kkrizka/pbv2_mass_test_adapter/(commit log)

2017-06-23 Initial import.
    [pbv2_7_test_adapters.sch, pbv2_mass_test_adapter.kicad_pcb, pbv2_mass_test_adapter.sch, pbv2_test_adapter.sch]
2017-06-23 Unique sheet names.
    [pbv2_7_test_adapters.sch, pbv2_mass_test_adapter.sch, pbv2_test_adapter.sch]
2017-06-23 Started adding HV connectors.
    [pbv2_7_test_adapters.sch, pbv2_mass_test_adapter.kicad_pcb, pbv2_mass_test_adapter.sch, pbv2_test_adapter.sch]
2017-06-23 Schematic complete.
    [pbv2_7_test_adapters.sch, pbv2_mass_test_adapter.sch, pbv2_test_adapter.sch]
2017-06-23 aesthetic changes
    [pbv2_mass_test_adapter.sch]
2017-08-11 pads for one PB layed-out
    [pbv2_7_test_adapters.sch, pbv2_mass_test_adapter.kicad_pcb, pbv2_test_adapter.sch]
2017-08-14 Start of routing.
    [pbv2_mass_test_adapter.kicad_pcb, pbv2_mass_test_adapter.sch]
2017-08-14 Relayout one PB station.
    [pbv2_mass_test_adapter.kicad_pcb, pbv2_mass_test_adapter.sch, pbv2_test_adapter.sch]
2017-08-15 Array all of the components.
    [pbv2_mass_test_adapter.kicad_pcb, pbv2_mass_test_adapter.sch]
2017-08-15 Relayed out master PB station with the output right above it.
    [pbv2_mass_test_adapter.kicad_pcb, pbv2_mass_test_adapter.sch]
2017-08-15 Started adding output ports for other mass sheets.
    [pbv2_7_test_adapters.sch, pbv2_mass_test_adapter.kicad_pcb, pbv2_mass_test_adapter.sch, pbv2_test_adapter.sch]
2017-08-15 start work on other sheets
    [pbv2_7_test_adapters.sch, pbv2_mass_test_adapter.sch, pbv2_test_adapter.sch]
2017-08-15 Moved the output ports for all sheets.
    [pbv2_mass_test_adapter.kicad_pcb, pbv2_test_adapter.sch]
2017-08-15 Turned individual test stations into a 2D grid.
    [pbv2_mass_test_adapter.kicad_pcb]
2017-08-15 Initial layout ccompleted.
    [pbv2_mass_test_adapter.kicad_pcb]
2017-08-16 Fixed a bunch of PCB errors.
    [pbv2_7_test_adapters.sch, pbv2_mass_test_adapter.kicad_pcb, pbv2_mass_test_adapter.sch, pbv2_test_adapter.sch]
2017-08-17 Remove stopmass from PB cooling pads.
    [pbv2_mass_test_adapter.kicad_pcb]
2017-08-17 Add gerber files.
    [pbv2_mass_test_adapter-B.Cu.gbr, pbv2_mass_test_adapter-B.Mask.gbr, pbv2_mass_test_adapter-B.SilkS.gbr, pbv2_mass_test_adapter-F.Cu.gbr, pbv2_mass_test_adapter-F.Mask.gbr, pbv2_mass_test_adapter-F.SilkS.gbr, pbv2_mass_test_adapter-NPTH.drl, pbv2_mass_test_adapter.drl]
2017-08-17 Added vaccum holes.
    [pbv2_mass_test_adapter-B.Cu.gbr, pbv2_mass_test_adapter-B.Mask.gbr, pbv2_mass_test_adapter-B.SilkS.gbr, pbv2_mass_test_adapter-F.Cu.gbr, pbv2_mass_test_adapter-F.Mask.gbr, pbv2_mass_test_adapter-F.SilkS.gbr, pbv2_mass_test_adapter-NPTH.drl, pbv2_mass_test_adapter.drl]
2017-08-17 Fix bondpad reference numbers in sheet 1/1.
    [pbv2_mass_test_adapter.kicad_pcb, pbv2_test_adapter.sch]
2017-08-17 Attemp to fix more W* pad names.
    [pbv2_test_adapter.sch]
2017-08-19 Remove everything but one PB from pcb. Remake schematic with big pinout for everything.
    [pbv2_3_test_adapters.sch, pbv2_7_test_adapters.sch, pbv2_mass_test_adapter.kicad_pcb, pbv2_mass_test_adapter.sch, pbv2_test_adapter.sch]
2017-08-20 Layedout a single PB using the pin-header design.
    [pbv2_3_test_adapters.sch, pbv2_mass_test_adapter.kicad_pcb]
2017-08-20 copied the layout to all PBs
    [pbv2_mass_test_adapter.kicad_pcb]
2017-08-20 duplicated zones
    [pbv2_3_test_adapters.sch, pbv2_mass_test_adapter.kicad_pcb, pbv2_test_adapter.sch]
2017-08-20 More zone renaming.
    [pbv2_mass_test_adapter.kicad_pcb]
2017-08-20 Finished with 3x3 layout.
    [pbv2_mass_test_adapter.kicad_pcb]
2017-08-20 Fix reference text positions.
    [pbv2_mass_test_adapter.kicad_pcb]
2018-02-12 Copy Sufia Haque's version of the layout.
    [pbv2_mass_test_adapter.kicad_pcb]
2018-02-12 Use LBL KiCad library.
    [pbv2_3_test_adapters.sch, pbv2_mass_test_adapter.sch, pbv2_test_adapter.sch]
2018-02-15 Relayout the top left powerboard.
    [pbv2_mass_test_adapter.kicad_pcb]
2018-02-15 Cleaup tracks.
    [pbv2_mass_test_adapter.kicad_pcb]
2018-02-15 Copy pad layout to all other pads.
    [pbv2_mass_test_adapter.kicad_pcb, pbv2_mass_test_adapter.sch]
2018-02-15 Add powerboard outline.
    [pbv2_mass_test_adapter.kicad_pcb]
2018-02-15 Add FEAST thermal relief. Add other PB connections.
    [pbv2_mass_test_adapter.kicad_pcb]
2018-02-15 Layout grid.
    [pbv2_mass_test_adapter.kicad_pcb]
2018-02-15 Connect VOUT pads.
    [pbv2_mass_test_adapter.kicad_pcb]
2018-02-15 Remove random via.
    [pbv2_mass_test_adapter.kicad_pcb]
2018-02-15 Add VOUT tracks.
    [pbv2_mass_test_adapter.kicad_pcb]
2018-02-16 Route I2C signals.
    [pbv2_mass_test_adapter.kicad_pcb]
2018-02-16 Start tracing HVOUT.
    [pbv2_mass_test_adapter.kicad_pcb]
2018-02-16 Update schematic.
    [pbv2_3_test_adapters.sch, pbv2_mass_test_adapter.kicad_pcb, pbv2_mass_test_adapter.sch, pbv2_test_adapter.sch]
2018-02-16 Route HV out.
    [pbv2_3_test_adapters.sch, pbv2_mass_test_adapter.kicad_pcb, pbv2_test_adapter.sch]
2018-02-16 Route LV.
    [pbv2_3_test_adapters.sch, pbv2_mass_test_adapter.kicad_pcb, pbv2_test_adapter.sch]
2018-02-16 Move VOUT pins one up. Route HV_IN.
    [pbv2_3_test_adapters.sch, pbv2_mass_test_adapter.kicad_pcb]
2018-02-16 Start LVIN layout.
    [pbv2_mass_test_adapter.kicad_pcb]
2018-02-16 Fill LV_IN.
    [pbv2_3_test_adapters.sch, pbv2_mass_test_adapter.kicad_pcb, pbv2_test_adapter.sch]
2018-02-17 Free up FEAST area.
    [pbv2_mass_test_adapter.kicad_pcb]
2018-02-17 Add vaccum holes to schematic. Implement an example of coil.
    [pbv2_3_test_adapters.sch, pbv2_mass_test_adapter.kicad_pcb, pbv2_test_adapter.sch]
2018-02-17 Add alignment holes to schematic.
    [pbv2_mass_test_adapter.kicad_pcb, pbv2_test_adapter.sch]
2018-02-17 Add holdmedown holes.
    [pbv2_3_test_adapters.sch, pbv2_mass_test_adapter.kicad_pcb, pbv2_test_adapter.sch]
2018-02-17 Fix LV zones.
    [pbv2_mass_test_adapter.kicad_pcb]
2018-02-17 Replicate scripts improved. Hide hole references.
    [pbv2_mass_test_adapter.kicad_pcb]
2018-02-17 Add gridding of things without a net.
    [pbv2_mass_test_adapter.kicad_pcb]
2018-02-19 Fix references. Fix zones.
    [pbv2_3_test_adapters.sch, pbv2_mass_test_adapter.kicad_pcb, pbv2_test_adapter.sch]
2018-02-19 Add missing trace.
    [pbv2_mass_test_adapter.kicad_pcb]
2018-02-19 Add cooling plate mounting holes.
    [pbv2_mass_test_adapter.kicad_pcb]
2018-02-19 Add edge cuts.
    [pbv2_mass_test_adapter.kicad_pcb]
2018-02-19 Synchronize reference positions.
    [pbv2_mass_test_adapter.kicad_pcb]
2018-02-19 Export gerbers.
    [pbv2_mass_test_adapter-B.Cu.gbr, pbv2_mass_test_adapter-B.Mask.gbr, pbv2_mass_test_adapter-B.SilkS.gbr, pbv2_mass_test_adapter-Edge.Cuts.gbr, pbv2_mass_test_adapter-F.Cu.gbr, pbv2_mass_test_adapter-F.Mask.gbr, pbv2_mass_test_adapter-F.SilkS.gbr, pbv2_mass_test_adapter-In1.Cu.gbr]
